QinHeIntel/Walldraw/Schematic diagram原理图/04. SD卡接线图.png

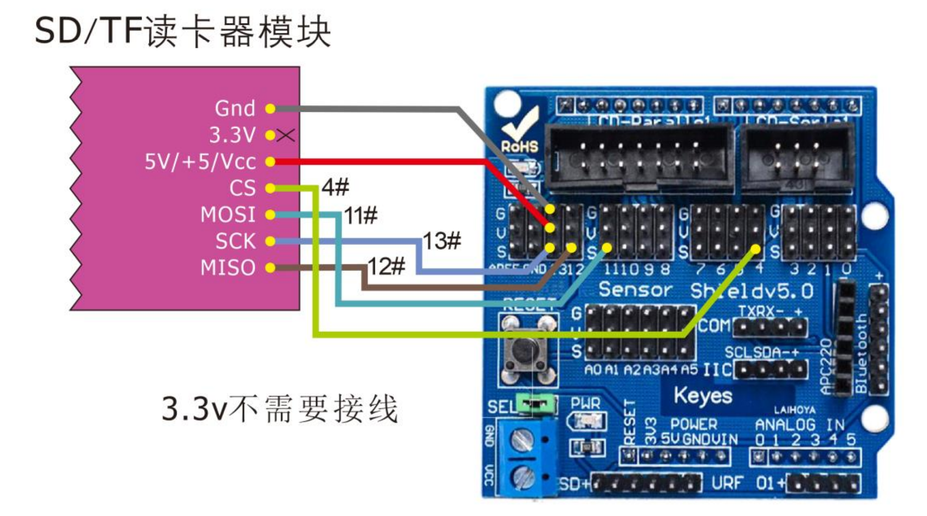
Schematic diagram原理图/04. SD卡接线图.png
