QinHeIntel/Walldraw/Schematic diagram原理图/03. 盾板插接图.png

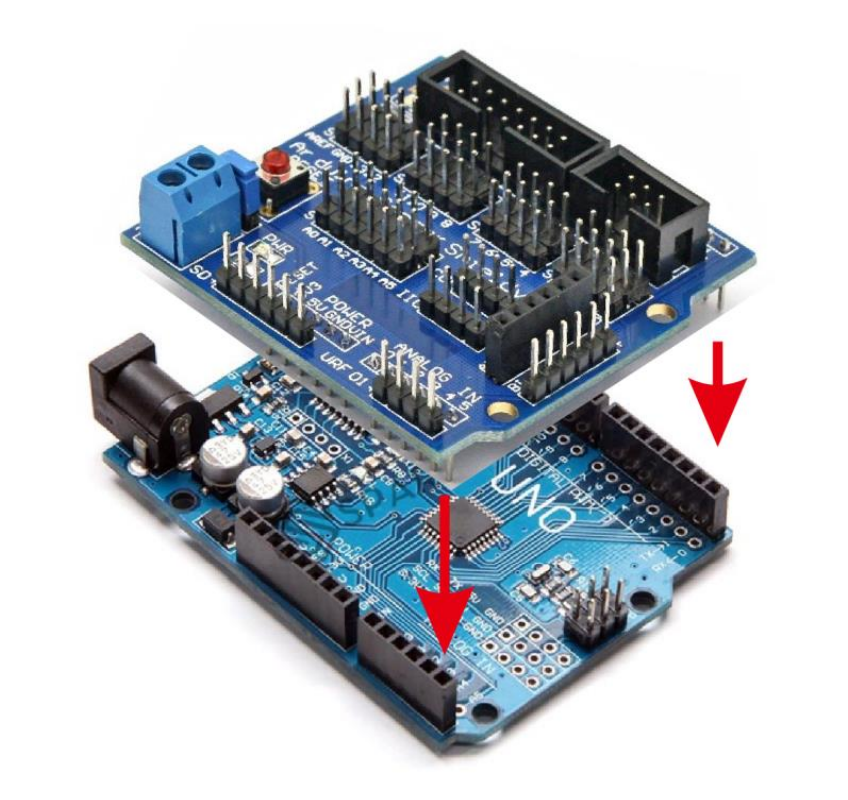
Schematic diagram原理图/03. 盾板插接图.png
