QinHeIntel/Walldraw/墙画机SD卡使用教学.pdf

www.qhebot.com

# 墙画机 SD 卡使用教学

深圳市沁和智能科技有限公司

第一步

首先按照组装教程 PDF 里面进行接线，这一步从组装教程第 19 页开

始看，按照接线图进行接线。

第二步

将 U 盘插入电脑中，选择格式化，格式化的文件系统选择

FAT32 格式，如下图所示

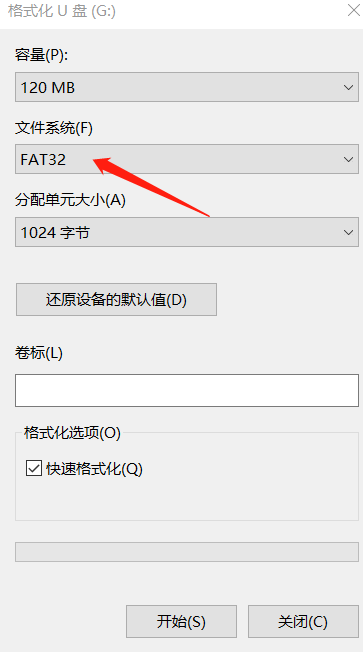
[picture p3: figure]

第三步

将你要绘画的 GCODE 文件，重新命名为[1.nc]

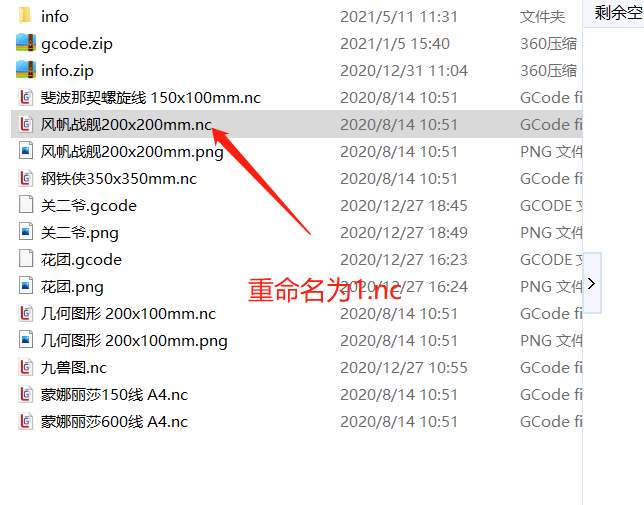
[picture p4: figure]

第四部

将文件拷贝到 U 盘中

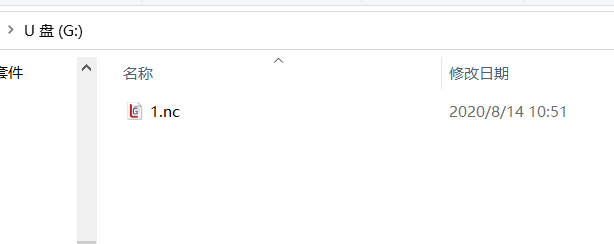
[picture p5: figure]

然后将 sd 卡插入 sd 模块即可。
