QinHeIntel/Walldraw/Schematic diagram原理图/01. 完整图.png

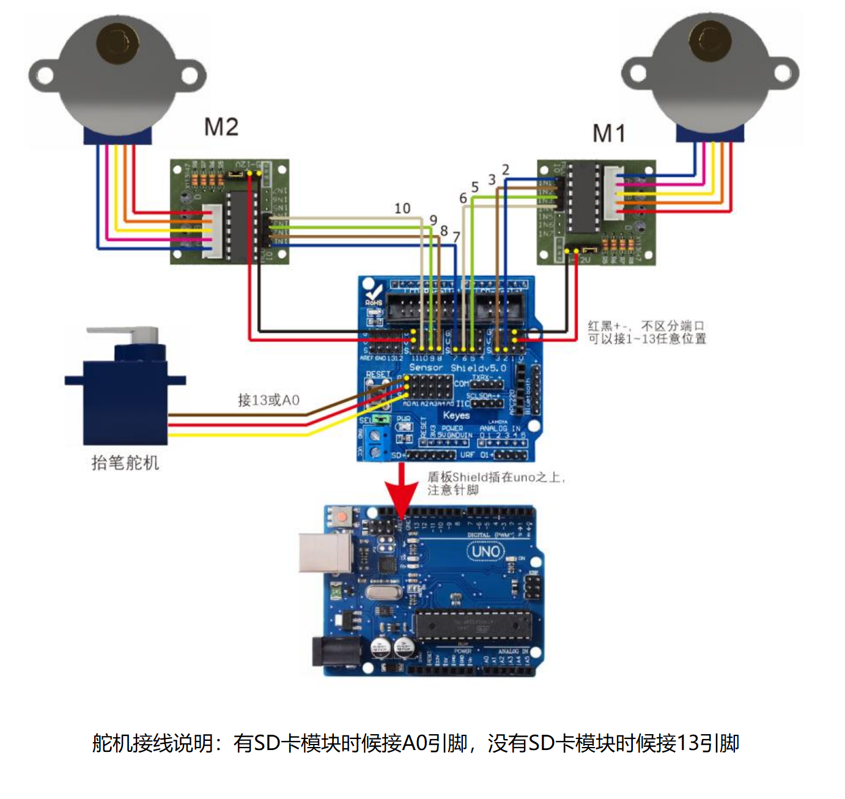
Schematic diagram原理图/01. 完整图.png
