QinHeIntel/Walldraw/Schematic diagram原理图/02. 局部放大图.png

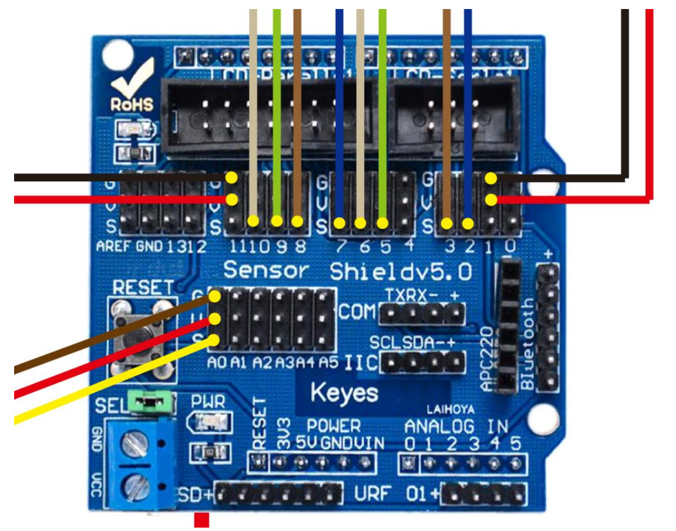
Schematic diagram原理图/02. 局部放大图.png
