QinHeIntel/Walldraw/Schematic diagram原理图/墙画机原理图.pdf

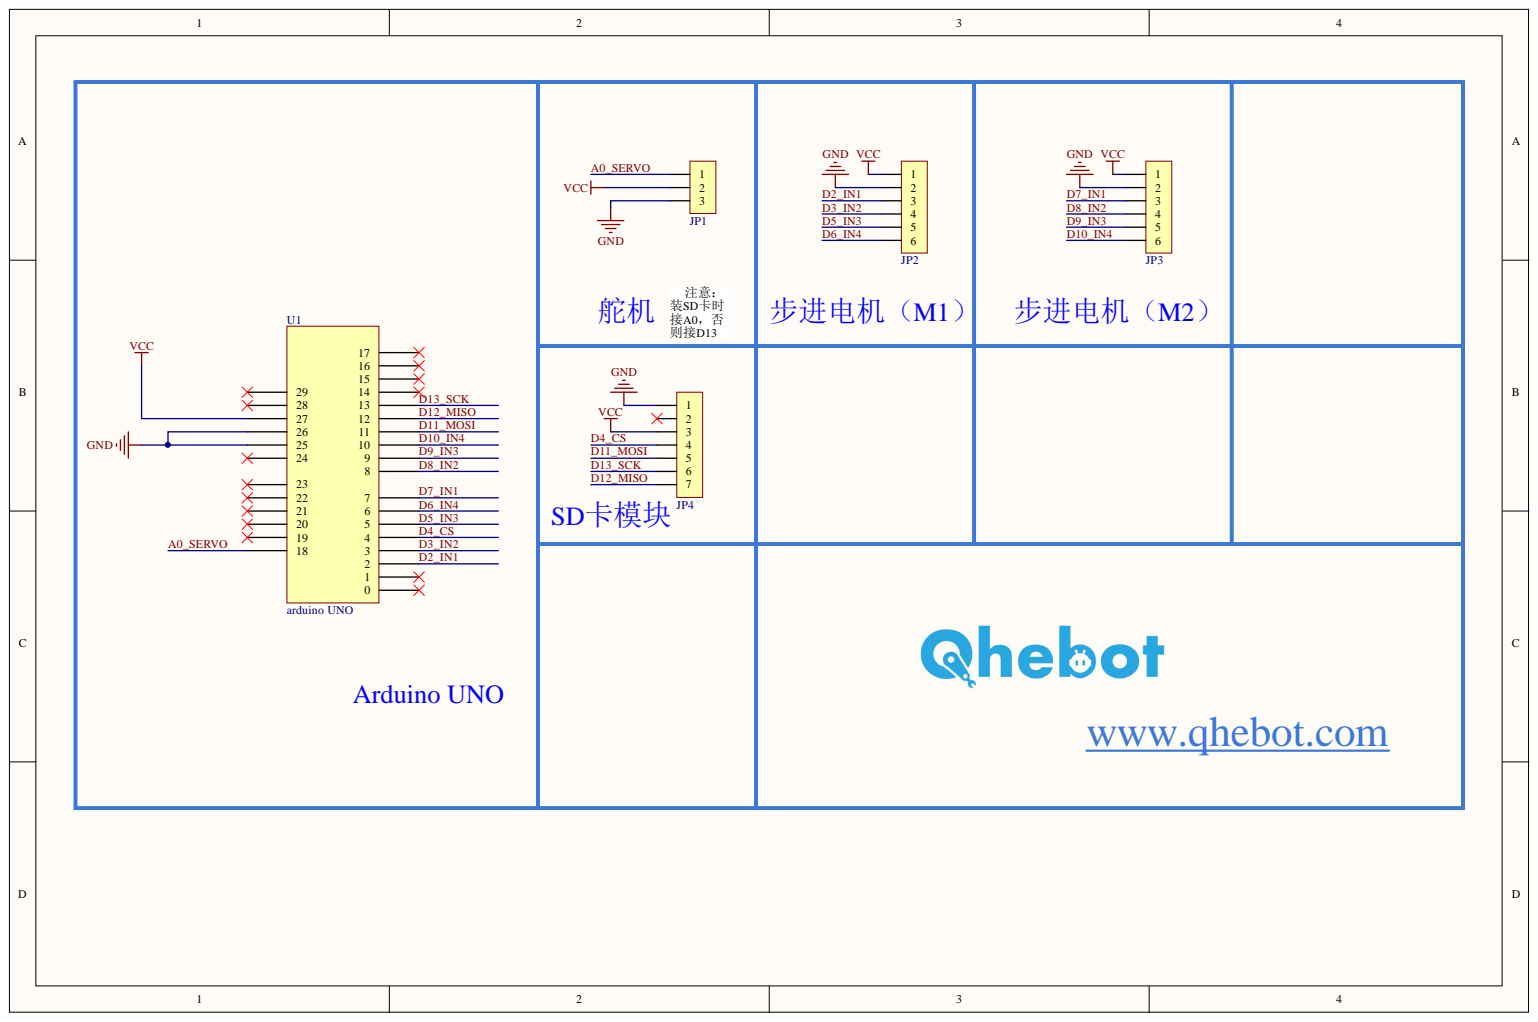
[picture p35: page 1]
